Triumph-alt/TrafficLight/BOM_Board2_1_PCB3_1_2025-10-17.xlsx

No. | Quantity | Comment | Designator | Footprint | Value | Manufacturer Part | Manufacturer | Supplier Part | Supplier | Name
1 | 1 | 100nF | C3 | CAP-TH_BD4.0-P1.50-D0.8-FD | 100nF | KS104M050C07RR0VH2FP0 | CX(承兴) | C45664 | LCSC | 100nF
2 | 1 | 10uF | C4 | CAP-TH_BD5.0-P2.00-D0.8-FD | 10uF | ERS1HM100D11OT | AISHI(艾华集团) | C106654 | LCSC | 10uF
3 | 1 | B-2100S02P-A110 | H1 | HDR-TH_2P-P2.54-V-M-1 |  | B-2100S02P-A110 | Ckmtw(灿科盟) | C124375 | LCSC
4 | 1 | 支绿 | LED1 | LED-TH_BD3.9-P2.54-RD |  | 支绿 | EVERLIGHT(亿光) | C778892 | LCSC | 支绿
5 | 1 | 支黄 | LED2 | LED-TH_BD3.9-P2.54-RD |  | 支黄 | EVERLIGHT(亿光) | C778892 | LCSC | 支黄
6 | 1 | 支红 | LED3 | LED-TH_BD3.9-P2.54-RD |  | 支红 | EVERLIGHT(亿光) | C778892 | LCSC | 支红
7 | 1 | 主黄 | LED5 | LED-TH_BD3.9-P2.54-RD |  | 主黄 | EVERLIGHT(亿光) | C778892 | LCSC | 主黄
8 | 1 | 主红 | LED6 | LED-TH_BD3.9-P2.54-RD |  | 主红 | EVERLIGHT(亿光) | C778892 | LCSC | 主红
9 | 1 | SM410501N/8个 | LED7 | LED-SEG-TH_10P-L12.7-W19.0-P2.54-S15.24-BL |  | SM410501N/8个 | ARKLED(方舟) | C252200 | LCSC | SM410501N/8个
10 | 1 | SM410501N/8十 | LED8 | LED-SEG-TH_10P-L12.7-W19.0-P2.54-S15.24-BL |  | SM410501N/8十 | ARKLED(方舟) | C252200 | LCSC | SM410501N/8十
11 | 2 | 48.7kΩ | R3,R4 | RES-TH_BD2.4-L6.3-P10.30-D0.6 | 48.7kΩ | MFR-25FBF52-48K7 | YAGEO(国巨) | C1365709 | LCSC | 48.7kΩ
12 | 2 | 1kΩ | R5,R6 | RES-TH_BD2.3-L6.5-P10.50-D0.5 | 1kΩ | MF1/4W-1KΩ±1%T52 | 华星机电 | C713997 | LCSC | 1kΩ
13 | 4 | M3螺丝 | SCREW1,SCREW2,SCREW3,SCREW4 | M3螺丝
14 | 1 | NE555N | U2 | DIP-8_L9.8-W6.6-P2.54-LS7.6-BL |  | NE555N | HGSEMI(华冠) | C398063 | LCSC | NE555N
15 | 2 | XD74LS190 | U3,U4 | DIP-16_L20.0-W6.4-P2.54-LS7.6-BL |  | XD74LS190 | XINLUDA(信路达) | C707104 | LCSC | XD74LS190
16 | 1 | XD74LS08 | U5 | DIP-14_L19.4-W6.4-P2.54-LS7.6-BL |  | XD74LS08 | XINLUDA(信路达) | C521139 | LCSC | XD74LS08
17 | 1 | SN74LS191N | U6 | PDIP-16_L19.3-W6.4-P2.54-LS7.94-BL |  | SN74LS191N | TI(德州仪器) | C1523316 | LCSC | SN74LS191N
18 | 1 | SN74LS04N | U7 | DIP-14_L19.1-W6.4-P2.54-LS7.6-BL |  | SN74LS04N | LX(灵星芯微) | C22374093 | LCSC | SN74LS04N
19 | 1 | SN74LS32N | U8 | DIP-14_L19.1-W6.4-P2.54-LS7.6-BL |  | SN74LS32N | LX(灵星芯微) | C22466295 | LCSC | SN74LS32N
20 | 1 | XD74LS247个 | U9 | DIP-16_L19.3-W6.4-P2.54-LS7.6-BL |  | XD74LS247个 | XINLUDA(信路达) | C609771 | LCSC | XD74LS247个
21 | 1 | XD74LS247十 | U10 | DIP-16_L19.3-W6.4-P2.54-LS7.6-BL |  | XD74LS247十 | XINLUDA(信路达) | C609771 | LCSC | XD74LS247十
22 | 1 | 主绿 | 主绿 | LED-TH_BD3.9-P2.54-RD |  | 主绿 | EVERLIGHT(亿光) | C778892 | LCSC | 主绿
