Triumph-alt/TrafficLight/(list of files, drawings)

Other design files:
ProPrj_交通灯-升级款.epro
ProPrj_交通灯.epro
交通灯.ms14
